UVicRocketry/A4-Flight-Computer/hardware/A4-Flight-Computer/component-library/NVT4858HKZ/NVT4858_NXP.step

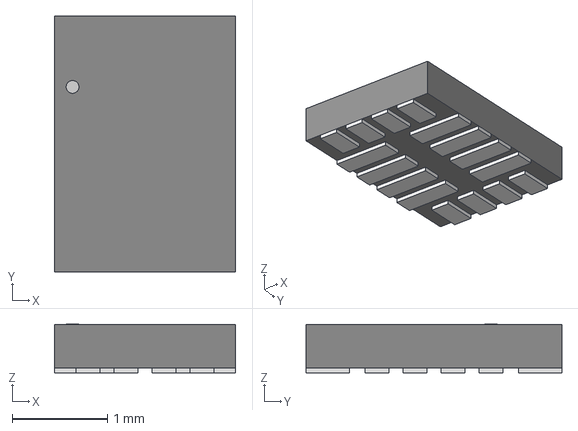
[picture p1: CAD file, 2026-11-14]
hardware/A4-Flight-Computer/component-library/NVT4858HKZ/NVT4858_NXP.step
1.90 x 2.69 x 0.511 mm
