UVicRocketry/A4-Flight-Computer/hardware/A4-Flight-Computer/component-library/ST1W008S4ER1500/st1w008s4er1500.stp

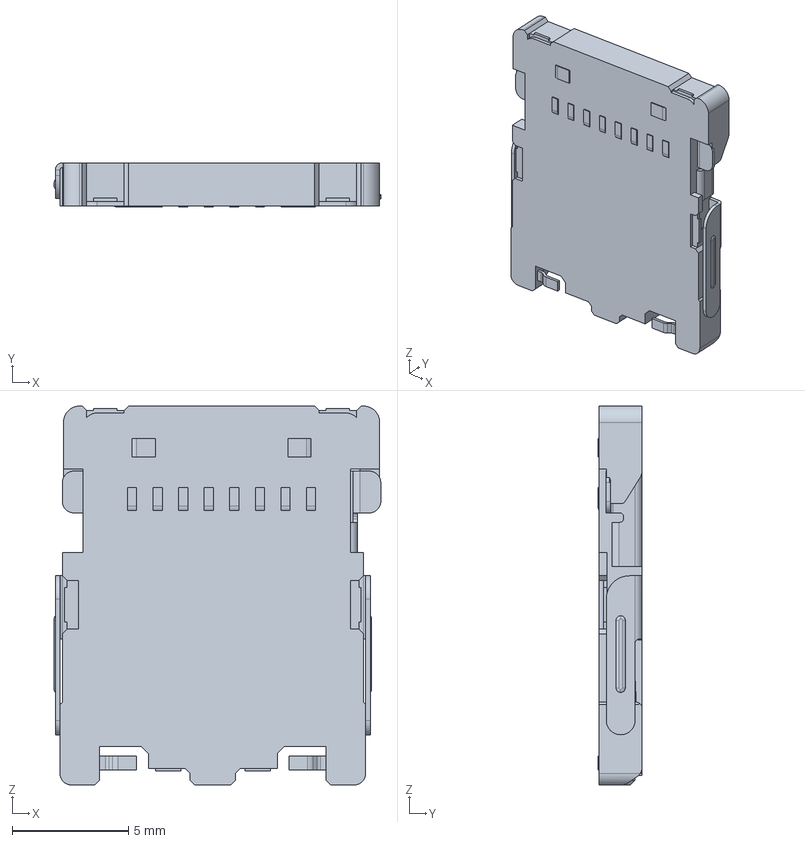
[picture p2: CAD file, 2026-11-14]
hardware/A4-Flight-Computer/component-library/ST1W008S4ER1500/st1w008s4er1500.stp
14.0 x 1.90 x 16.3 mm
