UVicRocketry/A4-Flight-Computer/hardware/A4-Flight-Computer/can.kicad_sch

## KiCad design hardware/A4-Flight-Computer/can.kicad_sch (2026-11-14)

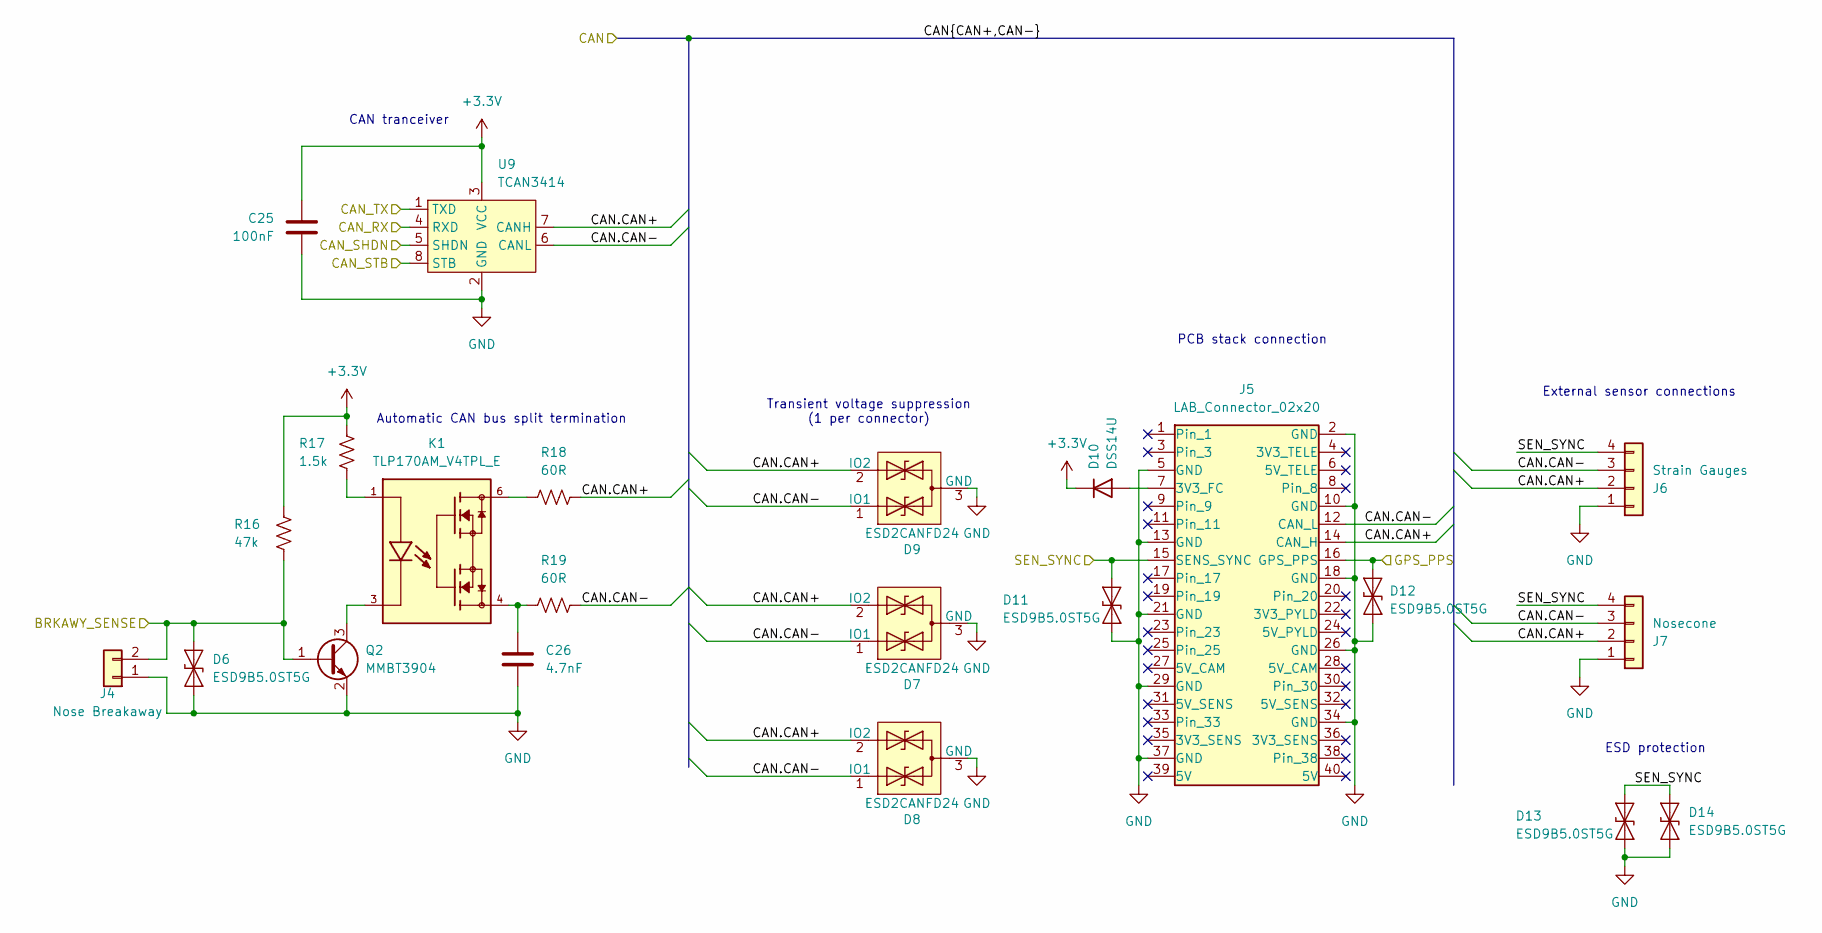
[picture p3: schematic can.kicad_sch]

Parts:
C25: 100nF; C_0402_1005Metric
C26: 4.7nF; C_0402_1005Metric
D6, D11, D12, D13, D14: ESD9B5.0ST5G; D_SOD-923
D7, D8, D9: ESD2CANFD24; ESD2CANFD24-SOT23
D10: DSS14U; D_SOD-123
J4: Nose Breakaway; JST_XH_S2B-XH-A_1x02_P2.50mm_Horizontal
J5: LAB_Connector_02x20; LAB_PCB_With_Header
J6: Strain Gauges; JST_XH_S4B-XH-A_1x04_P2.50mm_Horizontal
J7: Nosecone; JST_XH_S4B-XH-A_1x04_P2.50mm_Horizontal
K1: TLP170AM_V4TPL_E; RELAY_TLP170AM_V4TPL_E; MPN TLP170AM(V4TPL,E
Q2: MMBT3904; SOT-23
R16: 47k; R_0402_1005Metric
R17: 1.5k; R_0402_1005Metric
R18, R19: 60R; R_0402_1005Metric
U9: TCAN3414; TCAN3414DR-SOIC8

Connections:
+3.3V: C25.1, D10.1 (K), R16.1, R17.1, U9.3 (VCC)
BRKAWY_SENSE: D6.2 (A2), J4.2, Q2.1 (B), R16.2
CAN.CAN+: D7.2 (IO2), D8.2 (IO2), D9.2 (IO2), J5.14 (CAN_H), J6.2, J7.2, R18.2, U9.7 (CANH)
CAN.CAN-: D7.1 (IO1), D8.1 (IO1), D9.1 (IO1), J5.12 (CAN_L), J6.3, J7.3, R19.2, U9.6 (CANL)
CAN_RX: U9.4 (RXD)
CAN_SHDN: U9.5 (SHDN)
CAN_STB: U9.8 (STB)
CAN_TX: U9.1 (TXD)
GND: C25.2, C26.2, D6.1 (A1), D7.3 (GND), D8.3 (GND), D9.3 (GND), D11.1 (A1), D12.1 (A1), D13.1 (A1), D14.1 (A1), J4.1, J5.2 (GND), J5.5 (GND), J5.10 (GND), J5.13 (GND), J5.18 (GND), J5.21 (GND), J5.26 (GND), J5.29 (GND), J5.34 (GND), J5.37 (GND), J6.1, J7.1, Q2.2 (E), U9.2 (GND)
GPS_PPS: D12.2 (A2), J5.16 (GPS_PPS)
unnamed: C26.1, K1.4, R19.1
unnamed: D10.2 (A), J5.7 (3V3_FC)
unnamed: K1.1, R17.2
unnamed: K1.3, Q2.3 (C)
unnamed: K1.6, R18.1
SEN_SYNC: D11.2 (A2), D13.2 (A2), D14.2 (A2), J5.15 (SENS_SYNC), J6.4, J7.4

Notes on the sheet:
CAN tranceiver
Transient voltage suppression (1 per connector)
PCB stack connection
ESD protection
Automatic CAN bus split termination
External sensor connections
