UVicRocketry/A4-Flight-Computer/hardware/A4-Flight-Computer/sensors.kicad_sch

## KiCad design hardware/A4-Flight-Computer/sensors.kicad_sch (2026-11-14)

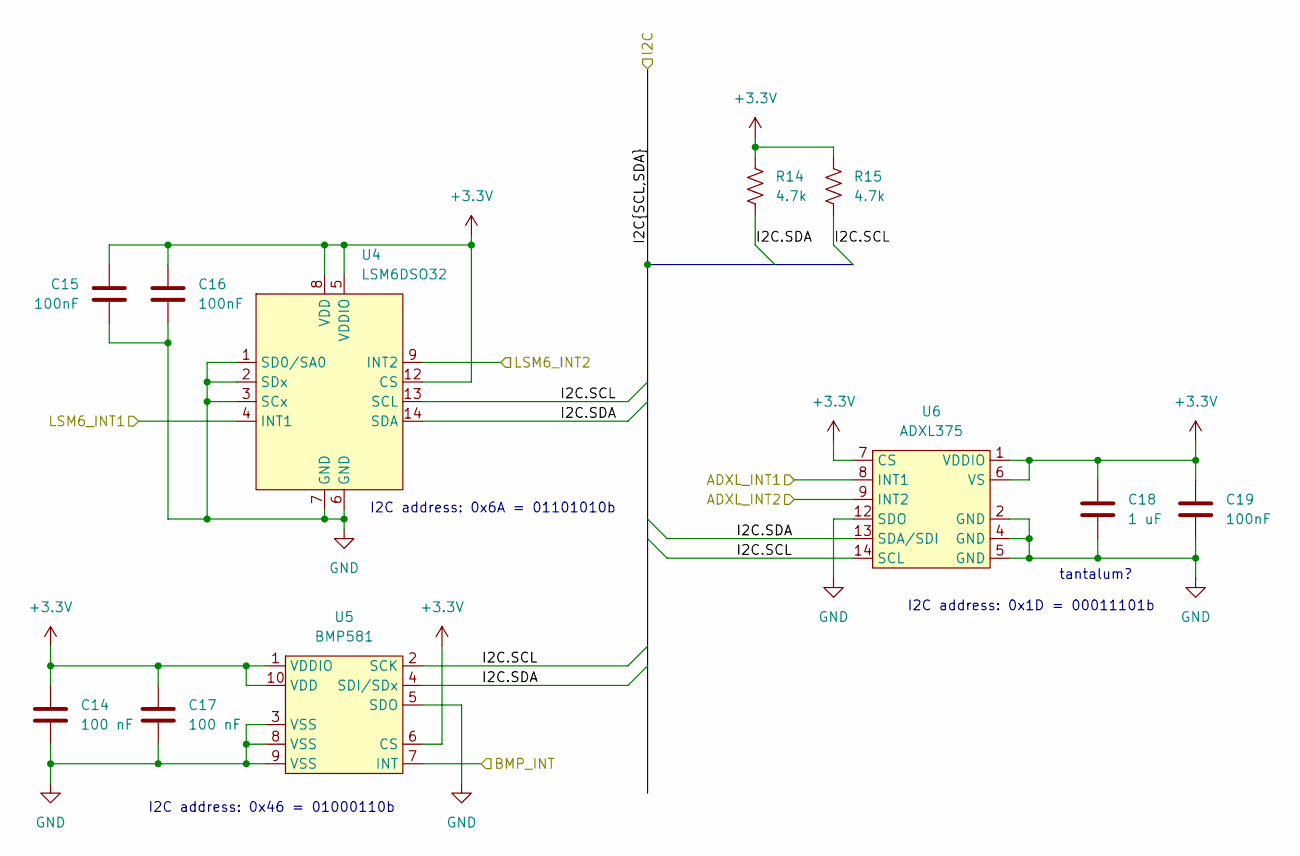
[picture p4: schematic sensors.kicad_sch]

Parts:
C14, C17: 100 nF; C_0402_1005Metric
C15, C16, C19: 100nF; C_0402_1005Metric
C18: 1 uF; C_0402_1005Metric
R14, R15: 4.7k; R_0402_1005Metric
U4: LSM6DSO32; LGA-14_3x2.5mm_P0.5mm_LayoutBorder3x4y
U5: BMP581
U6: ADXL375; ADXL375-LGA14

Connections:
+3.3V: C14.1, C15.1, C16.1, C17.1, C18.1, C19.1, R14.1, R15.1, U4.5 (VDDIO), U4.8 (VDD), U4.12 (CS), U5.1 (VDDIO), U5.6 (CS), U5.10 (VDD), U6.1 (VDDIO), U6.6 (VS), U6.7 (CS)
ADXL_INT1: U6.8 (INT1)
ADXL_INT2: U6.9 (INT2)
BMP_INT: U5.7 (INT)
GND: C14.2, C15.2, C16.2, C17.2, C18.2, C19.2, U4.1 (SD0/SA0), U4.2 (SDx), U4.3 (SCx), U4.6 (GND), U4.7 (GND), U5.3 (VSS), U5.5 (SDO), U5.8 (VSS), U5.9 (VSS), U6.2 (GND), U6.4 (GND), U6.5 (GND), U6.12 (SDO)
I2C.SCL: R15.2, U4.13 (SCL), U5.2 (SCK), U6.14 (SCL)
I2C.SDA: R14.2, U4.14 (SDA), U5.4 (SDI/SDx), U6.13 (SDA/SDI)
LSM6_INT1: U4.4 (INT1)
LSM6_INT2: U4.9 (INT2)

Notes on the sheet:
tantalum?
I2C address: 0x46 = 01000110b
I2C address: 0x1D = 00011101b
I2C address: 0x6A = 01101010b
