UVicRocketry/A4-Flight-Computer/software/A4-Flight-Computer/A4-Flight-Computer.ioc

Mcu.UserName=STM32H523RETx
PA11.Signal=USB_DM
PA12.Signal=USB_DP
PA13(JTMS/SWDIO).Signal=DEBUG_JTMS-SWDIO
PA14(JTCK/SWCLK).Signal=DEBUG_JTCK-SWCLK
PA15(JTDI).Signal=DEBUG_JTDI
PA4.GPIO_Label=ADXL_INT1
PA4.Signal=GPXTI4
PA5.GPIO_Label=ADXL_INT2
PA5.Signal=GPXTI5
PA6.GPIO_Label=LSM6_INT1
PA6.Signal=GPXTI6
PA7.GPIO_Label=LSM6_INT2
PA7.Signal=GPXTI7
PA8.Signal=I2C3_SCL
PB0.GPIO_Label=BMP_INT
PB0.Signal=GPXTI0
PB1.GPIO_Label=LED1
PB1.Signal=GPIO_Output
PB10.GPIO_Label=BRKWAY_SENSE
PB10.Signal=GPXTI10
PB12.Signal=FDCAN2_RX
PB13.Signal=FDCAN2_TX
PB14.GPIO_Label=CAN_SHDN
PB14.Signal=GPIO_Output
PB15.GPIO_Label=CAN_STB
PB15.Signal=GPIO_Output
PB2.GPIO_Label=LED2
PB2.Signal=GPIO_Output
PB3(JTDO/TRACESWO).Signal=DEBUG_JTDO-SWO
PB4(NJTRST).Signal=I2C3_SDA
PB5.Signal=USART6_TX
PB6.Signal=USART6_RX
PB8.Signal=SDMMC1_CKIN
PC10.Signal=SDMMC1_D2
PC11.Signal=SDMMC1_D3
PC12.Signal=SDMMC1_CK
PC14-OSC32_IN(OSC32_IN).Signal=RCC_OSC32_IN
PC15-OSC32_OUT(OSC32_OUT).Signal=RCC_OSC32_OUT
PC4.GPIO_Label=BUZZ_OUT
PC4.Signal=S_TIM2_CH4
PC6.GPIO_Label=PPS_IN
PC6.Signal=S_TIM3_CH1
PC7.GPIO_Label=SYNC_OUT
PC7.Signal=S_TIM3_CH2
PC8.Signal=SDMMC1_D0
PC9.Signal=SDMMC1_D1
PD2.Signal=SDMMC1_CMD
PH0-OSC_IN(PH0).Signal=RCC_OSC_IN
PH1-OSC_OUT(PH1).Signal=RCC_OSC_OUT
