UVicRocketry/A4-Flight-Computer/(commit log)

2026-10-21 add kicad project
2026-10-21 add .gitignore for STM32CubeIDE and KiCAD
2026-10-21 add stm32cubeide project
2026-10-26 add needed peripherals and timer configs
2026-10-26 Add pcb standard as git submodule
2026-10-26 add reference to pcb standard footprint/schematic symbols and replace header symbol
2026-10-30 update with new pcb standard revision
2026-11-01 update pcb standard; change to 4-layer board.
2026-11-01 add tcan3414 and esd2canfd24 symbols and footprints
2026-11-01 add 3.3v and ground planes; add can transceiver to pcb
2026-11-01 add lsm6dso32 schematic symbol
2026-11-02 add BMP581 footprint and symbol
2026-11-02 add ADXL375 footprint and symbol
2026-11-03 add CPT-9019A footprint
2026-11-03 add ST1W008S4ER1500 footprint and symbol
2026-11-06 add NVT4858HKZ footprint and symbol
2026-11-06 add sensors and sd card to schematic
2026-11-07 add SN74LVC1G17 footprint and symbol
2026-11-07 add TLP170AM footprint and symbol
2026-11-07 move can stuff to sub sheet, add can auto-termination, add input protections, add SENS_SYNC driver
2026-11-08 add breakaway_sense connection to uC; fix mis-assigned footprints
2026-11-08 update external oscillator settings, add brkawy_sense gpio pin
2026-11-09 add timer interrupt handlers
2026-11-09 add external interrupt handlers
2026-11-10 move breakaway_sense connection to uC to pin PB10
2026-11-13 update pcb standard
2026-11-13 add simple status LED blinker and debug launch configuration; first working build
