UVicRocketry/A4-Flight-Computer/(notices)

Notices in the files:
software/A4-Flight-Computer/Core/Inc/main.h:
Copyright (c) 2026 STMicroelectronics.
All rights reserved.
This software is licensed under terms that can be found in the LICENSE file
